zhenhaoshuai/PCB/README.md

AllItemForStudent  是一个STM32F407VET6的最小系统和画法
