zhenhaoshuai/PCB/AllItemForStudent/新建 XLS 工作表.xls

元器件 | 型号 | 个数
彩色LED | XL-5050RGBC-WS2812B | 10个
蜂鸣器 | TMB12A05 | 5个
开关 | TS-1088-AR02016 | 10个 | 4*3*2mm 立贴 轻触开关
数码管 | MHDC2551SRBW | 2个
振动马达 | LCM1027A2445F | 2个
Wifi模块 | ESP-12F(ESP8266MOD) | 2个
蓝牙模块 (https://list.szlcsc.com/catalog/11225.html) | VG6328A | 2个
摄像头 | 淘宝购买的 | 1个
温度传感器 | KNTC0603/10KF3950 | 20个 | 热敏电阻
湿度传感器 | AHT10 | 3个
继电器
MOS管
直流电机 |  | 10个 | 额定功率 0.02（W） | 有刷直流电动机 | 额定电压 1.5-6.0（V） | 额定电流 0.03（A） | 额定转速 5000（rpm） | 适用范围 1.5-6.0V | 3C额定电压范围 直流36V以下
步进电机 |  | 5个 | 额定功率 12（W） 产品类型 永磁同步电动机 额定电压 12（V）
扬声器 |  | 10个
麦克风 |  | 5个
液晶显示器 |  | 0个 | 用野火板子上的
