zhenhaoshuai/PCB/(list of files, drawings)

Other design files:
AllItemForStudent/AD_prj/AllStudentItem/AllStudentItem.PrjPcb
AllItemForStudent/AD_prj/AllStudentItem/PCB1.PcbDoc
AllItemForStudent/AD_prj/AllStudentItem/PcbLib1.PcbLib
AllItemForStudent/AD_prj/AllStudentItem/Schlib1.SchLib
AllItemForStudent/AD_prj/AllStudentItem/Sheet1.SchDoc
